wattnotions/esp32-soil-moisture-sensor/hardware/case/Shell.stl

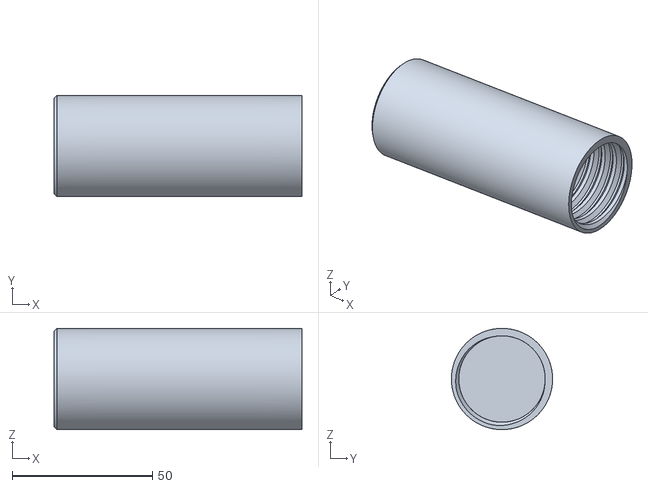
[picture p1: CAD file, 2022-06-05]
hardware/case/Shell.stl
88.4 x 36.1 x 36.1
