wattnotions/esp32-soil-moisture-sensor/hardware/case/Mount.stl

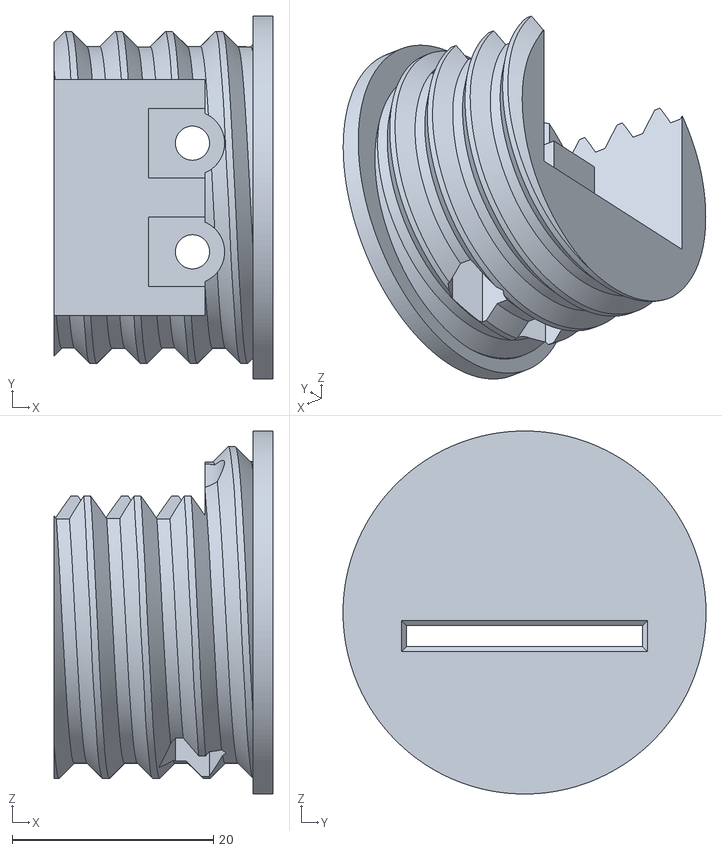
[picture p2: CAD file, 2022-06-05]
hardware/case/Mount.stl
21.8 x 36.1 x 36.1
