wattnotions/esp32-soil-moisture-sensor/hardware/soil-moisture-sensor.kicad_pcb

## KiCad design hardware/soil-moisture-sensor.kicad_pcb (2023-01-03)

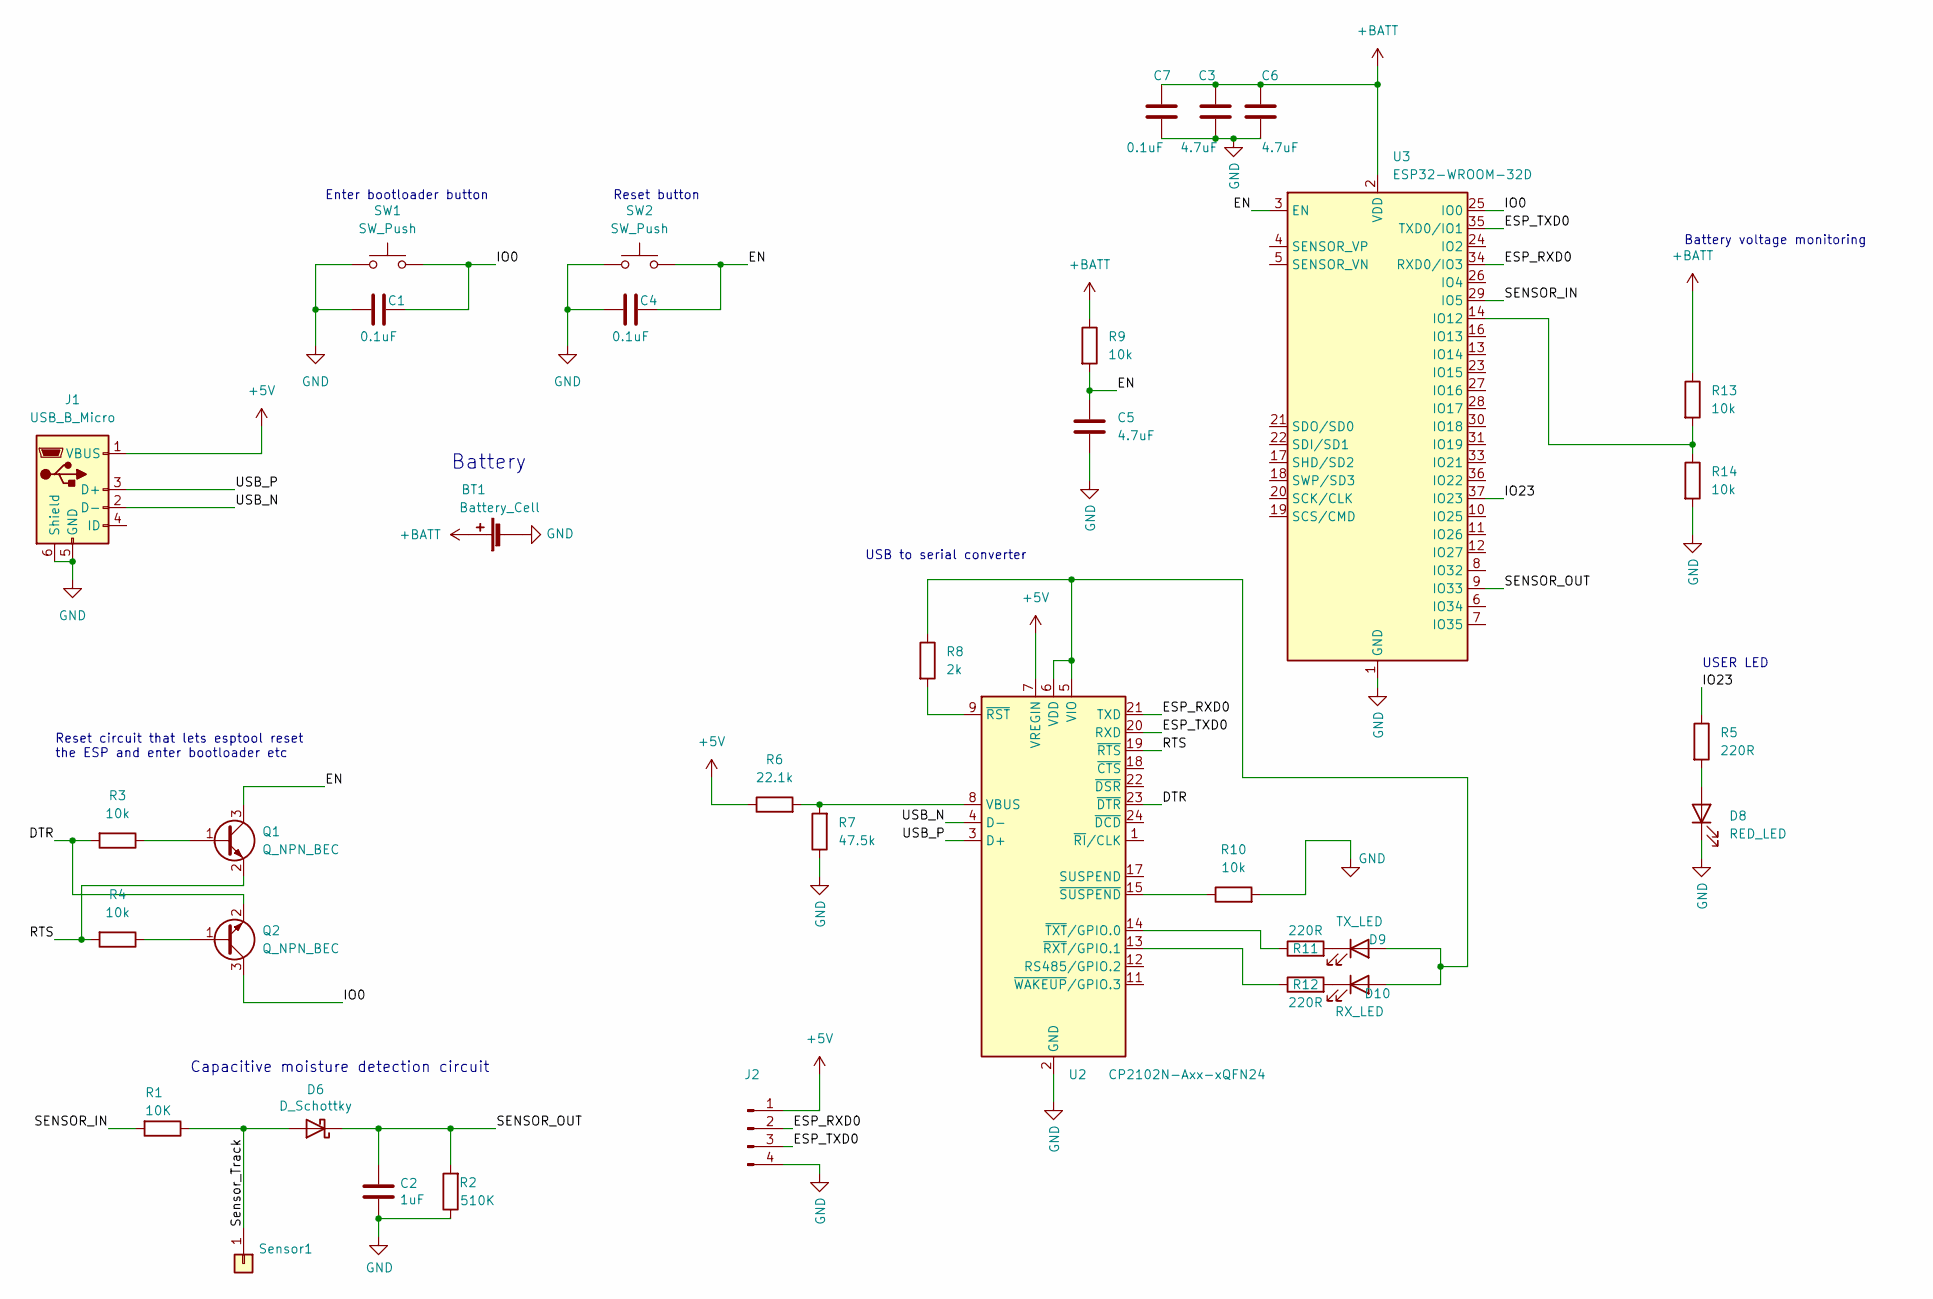
[picture p3: schematic soil-moisture-sensor.kicad_sch, Capacitive Soil Moisture Sensor]

Parts:
BT1: Battery_Cell; CR123A Battery Holder
C1, C4, C7: 0.1uF; C_0603_1608Metric; LCSC C694249
C2: 1uF; C_0603_1608Metric; LCSC C28323
C3, C5, C6: 4.7uF; C_0603_1608Metric; LCSC C108342
D6: D_Schottky; D_SOD-323_HandSoldering; LCSC C154819
D8: RED_LED; LED_0603_1608Metric; LCSC C118339
D9: TX_LED; LED_0603_1608Metric; LCSC C118339
D10: RX_LED; LED_0603_1608Metric; LCSC C118339
J1: USB_B_Micro; USB_Micro-B_Molex_47346-0001; LCSC C132560
J2: (no value)
Q1, Q2: Q_NPN_BEC; SOT-23; LCSC C164886
R1: 10K; R_0603_1608Metric; LCSC C17414
R2: 510K; R_0603_1608Metric; LCSC C17733
R3, R4, R9, R10, R13, R14: 10k; R_0603_1608Metric
R5: 220R; R_0603_1608Metric
R6: 22.1k; R_0603_1608Metric
R7: 47.5k; R_0603_1608Metric
R8: 2k; R_0603_1608Metric
R11, R12: 220R; R_0603_1608Metric; LCSC C365121
SW1, SW2: SW_Push; SW_SPST_B3U-1000P; LCSC C231329
Sensor1: Conn_01x01; Capacitive_Soil_Moisture_Sensor
U2: CP2102N-Axx-xQFN24; QFN-24-1EP_4x4mm_P0.5mm_EP2.6x2.6mm; LCSC C969151
U3: ESP32-WROOM-32D; ESP32-WROOM-32; LCSC C473012

Connections:
+5V: J1.1 (VBUS), J2.1, R6.1, U2.7 (VREGIN)
+BATT: BT1.1 (+), C3.1, C6.1, C7.1, R9.1, R13.1, U3.2 (VDD)
/DTR: Q2.2 (E), R3.2, U2.23 (~DTR)
/EN: C4.2, C5.1, Q1.3 (C), R9.2, SW2.2, U3.3 (EN)
/ESP_RXD0: J2.2, U2.21 (TXD), U3.34 (RXD0/IO3)
/ESP_TXD0: J2.3, U2.20 (RXD), U3.35 (TXD0/IO1)
/IO0: C1.2, Q2.3 (C), SW1.2, U3.25 (IO0)
/IO23: R5.1, U3.37 (IO23)
/RTS: Q1.2 (E), R4.2, U2.19 (~RTS)
/SENSOR_IN: R1.2, U3.29 (IO5)
/SENSOR_OUT: C2.1, D6.1 (K), R2.2, U3.9 (IO33)
/Sensor_Track: D6.2 (A), R1.1, Sensor1.1
/USB_N: J1.2 (D-), U2.4 (D-)
/USB_P: J1.3 (D+), U2.3 (D+)
GND: BT1.2 (-), C1.1, C2.2, C3.2, C4.1, C5.2, C6.2, C7.2, D8.1 (K), J1.5 (GND), J1.6 (Shield), J2.4, R2.1, R7.1, R10.2, R14.2, SW1.1, SW2.1, U2.2 (GND), U2.25 (GND), U3.1 (GND), U3.15 (GND), U3.38 (GND), U3.39 (GND)
unnamed: D8.2 (A), R5.2
unnamed: D9.1 (K), R11.2
unnamed: D10.1 (K), R12.2
unnamed: D9.2 (A), D10.2 (A), R8.1, U2.5 (VIO), U2.6 (VDD)
unnamed: Q1.1 (B), R3.1
unnamed: Q2.1 (B), R4.1
unnamed: R6.2, R7.2, U2.8 (VBUS)
unnamed: R8.2, U2.9 (~RST)
unnamed: R10.1, U2.15 (~SUSPEND)
unnamed: R11.1, U2.14 (~TXT/GPIO.0)
unnamed: R12.1, U2.13 (~RXT/GPIO.1)
unnamed: R13.2, R14.1, U3.14 (IO12)

Notes on the sheet:
USB to serial converter
USER LED
Reset circuit that lets esptool reset the ESP and enter bootloader etc
Battery voltage monitoring
Enter bootloader button
Battery
Capacitive moisture detection circuit
Reset button

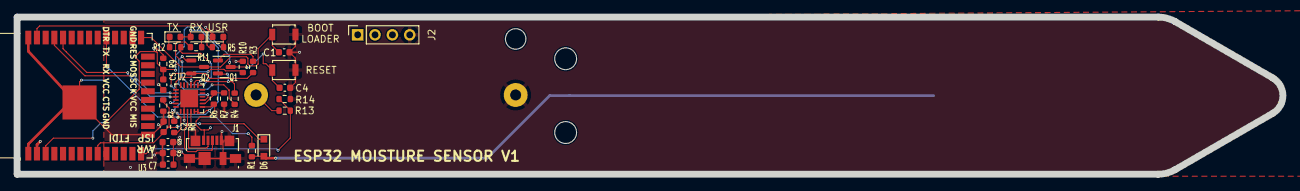
[picture p4: board soil-moisture-sensor.kicad_pcb from above]

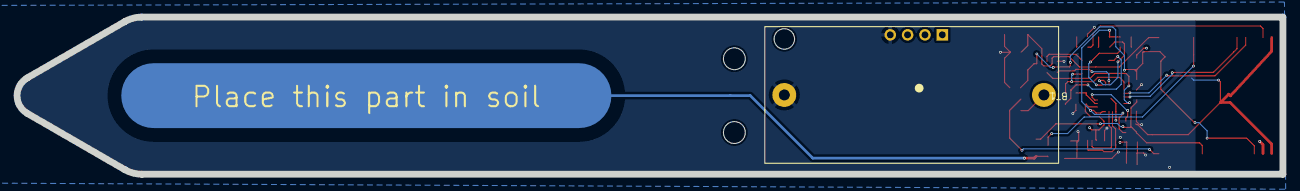
[picture p5: board soil-moisture-sensor.kicad_pcb from below]

Board: 4 copper layers, 185.3 x 23.0 mm, 35 parts (2 on the bottom side), 27 nets.
