wattnotions/esp32-soil-moisture-sensor/(commit log)

2022-06-05 started schematic
    [Mount.stl, Shell.stl, soil-moisture-sensor.kicad_pcb, soil-moisture-sensor.kicad_sch, soil-moisture-sensor.sch]
2022-06-07 schematic pretty much done
    [soil-moisture-sensor.kicad_sch]
2022-06-07 changed power structure - removed ldo
    [soil-moisture-sensor.csv, soil-moisture-sensor.kicad_pcb]
2022-06-07 placement pretty much done
    [soil-moisture-sensor-B_Cu.gbl, soil-moisture-sensor-B_Mask.gbs, soil-moisture-sensor-B_Paste.gbp, soil-moisture-sensor-B_Silkscreen.gbo, soil-moisture-sensor-Edge_Cuts.gm1, soil-moisture-sensor-F_Cu.gtl, soil-moisture-sensor-F_Mask.gts, soil-moisture-sensor-F_Paste.gtp]
2022-06-09 updated cr123a fp
    [soil-moisture-sensor.kicad_pcb, soil-moisture-sensor.kicad_sch]
2022-06-11 layout finished
    [soil-moisture-sensor-B_Cu.gbl, soil-moisture-sensor-B_Mask.gbs, soil-moisture-sensor-B_Paste.gbp, soil-moisture-sensor-B_Silkscreen.gbo, soil-moisture-sensor-Edge_Cuts.gm1, soil-moisture-sensor-F_Cu.gtl, soil-moisture-sensor-F_Mask.gts, soil-moisture-sensor-F_Paste.gtp]
2022-06-15 removed esd diodes, changed sensor out to adc pin
    [soil-moisture-sensor-B_Cu.gbl, soil-moisture-sensor-B_Mask.gbs, soil-moisture-sensor-B_Paste.gbp, soil-moisture-sensor-B_Silkscreen.gbo, soil-moisture-sensor-Edge_Cuts.gm1, soil-moisture-sensor-F_Cu.gtl, soil-moisture-sensor-F_Mask.gts, soil-moisture-sensor-F_Paste.gtp]
2022-06-29 re-did a load of routing
    [soil-moisture-sensor-B_Cu.gbl, soil-moisture-sensor-B_Mask.gbs, soil-moisture-sensor-B_Paste.gbp, soil-moisture-sensor-B_Silkscreen.gbo, soil-moisture-sensor-Edge_Cuts.gm1, soil-moisture-sensor-F_Cu.gtl, soil-moisture-sensor-F_Mask.gts, soil-moisture-sensor-F_Paste.gtp]
2023-01-03 added bat mon circuit, made bat led a user led
    [soil-moisture-sensor.csv, soil-moisture-sensor.kicad_pcb, soil-moisture-sensor.kicad_sch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]
2023-01-03 FIXED SOME DRC ERRORS
    [soil-moisture-sensor.kicad_pcb, soil-moisture-sensor.kicad_sch]
2023-01-03 added debug header and fixed more drc issues
    [soil-moisture-sensor-B_Cu.gbl, soil-moisture-sensor-B_Mask.gbs, soil-moisture-sensor-B_Paste.gbp, soil-moisture-sensor-B_Silkscreen.gbo, soil-moisture-sensor-Edge_Cuts.gm1, soil-moisture-sensor-F_Cu.gtl, soil-moisture-sensor-F_Mask.gts, soil-moisture-sensor-F_Paste.gtp]
2023-01-03 changed diode to one in stock on lcsc
    [soil-moisture-sensor.csv, soil-moisture-sensor.kicad_sch]
