wattnotions/esp32-soil-moisture-sensor/(notices)

Notices in the files:
hardware/soil-moisture-sensor.kicad_sch:
Licensed under CERN-OHL-P v2
